Saren125/dc-dc/eskd documentation/dc-dc преобразователь перечень элементов.pdf

Изм. Лист | № докум. | Подп. | Дата
| Разраб. | | | Преoбразователь DC-DC понижающий импульсный Перечень элементов | Лит. | Лист | Листов
Пров. | | | | | | 1 2
Н.контр. Инв. № подл. Подп. и дата Взам. инв. № Инв. № дубл. Подп. и дата | Утв. Справ. № Перв. примен. | Конденсаторы
C1,C3 | Конденсатор керамический 0.1 мкФ 50В 10% 0603 GCM188R71H104KA57D Murata | 2
C2 | Конденсатор керамический 10 мкФ 50В 10% 1210 10мкФ X7R 50В 10% 1210, GRM32ER71H106K Murata | 1
C4,C5 | Конденсатор керамический 22 мкФ 16В 10% 0603 GRM188R61C225KE15D Murata | 2
C6 | Конденсатор керамический 10 нФ 50В 5% 0603 GRM1885C1H103JA01D Murata | 1

Фильтры

FL1 | Фильтр DLW5BTM102SQ2L Murata | 1
| Предохранители
FU1 | Предохранитель самовосстанавливающийся 30В 2.6A 1812 1812L260/30MR LittleFuse | 1
| Катушки индуктивности
L1 | Катушка индуктивности 15 мкГн CDSPRH127-150M SCE | 1
| Резисторы
R1 | Резистор 10 кОм 0.1 Вт 0603 RT0603BRB0710KL Yageo | 1
R2,R3 Резистор 100 кОм 0.1 Вт 0603 RT0603BRD07100KL Yageo | | 2
R4 | Резистор 91 кОм 0.1 Вт 0603 RC0603FR-0791KL Yageo | 1
R5 | Резистор 17.8 кОм 0.1 Вт 0603 RC0603FR-0717K8L Yageo | 1

Поз.
обозначение
Наименование | Кол. Примечание
Копировал | Формат A4

Лист

2 Инв. № подл. Подп. и дата Взам. инв. № Инв. № дубл. Подп. и дата | Изм. Лист | № докум. | Подп. | Дата

Микросхемы

U1 | DC-DC преобразователь понижающий ADJ 3.5А 200кГц-2.5МГц LMR14030SDDAR Texas Instruments | 1
| Приборы полупроводниковые
VD1 | Диод защитный 24В 1500Вт SMC SMCJ24A EVER SEMICONDUCTOR | 1
VD2 | Стабилитрон 12В 0.2Вт SOD-323 BZT52C12S Hottech | 1
VD3 | Диод Шоттки SMB SK56B Hottech | 1
VT1 | Транзистор P-MOSFET 30В 4.1А AO3407A SOT-23-3 Youtai | 1

Соединители

X1,X2 Клеммник винтовой, 2-контактный, 5мм, прямой на плату DG300-5.0-02P-12 2

Поз.
обозначение
Наименование | Кол. Примечание
Копировал | Формат A4
