Saren125/dc-dc/3d.jpg

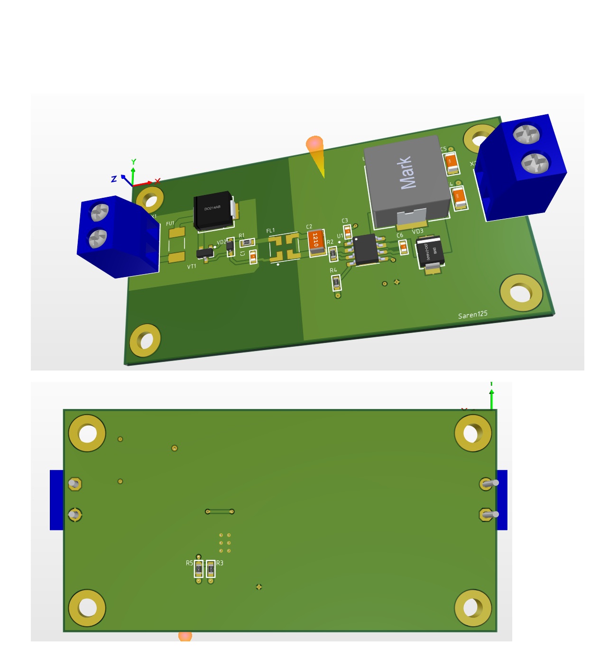
3d.jpg
