Saren125/dc-dc/eskd documentation/converter schematic.pdf

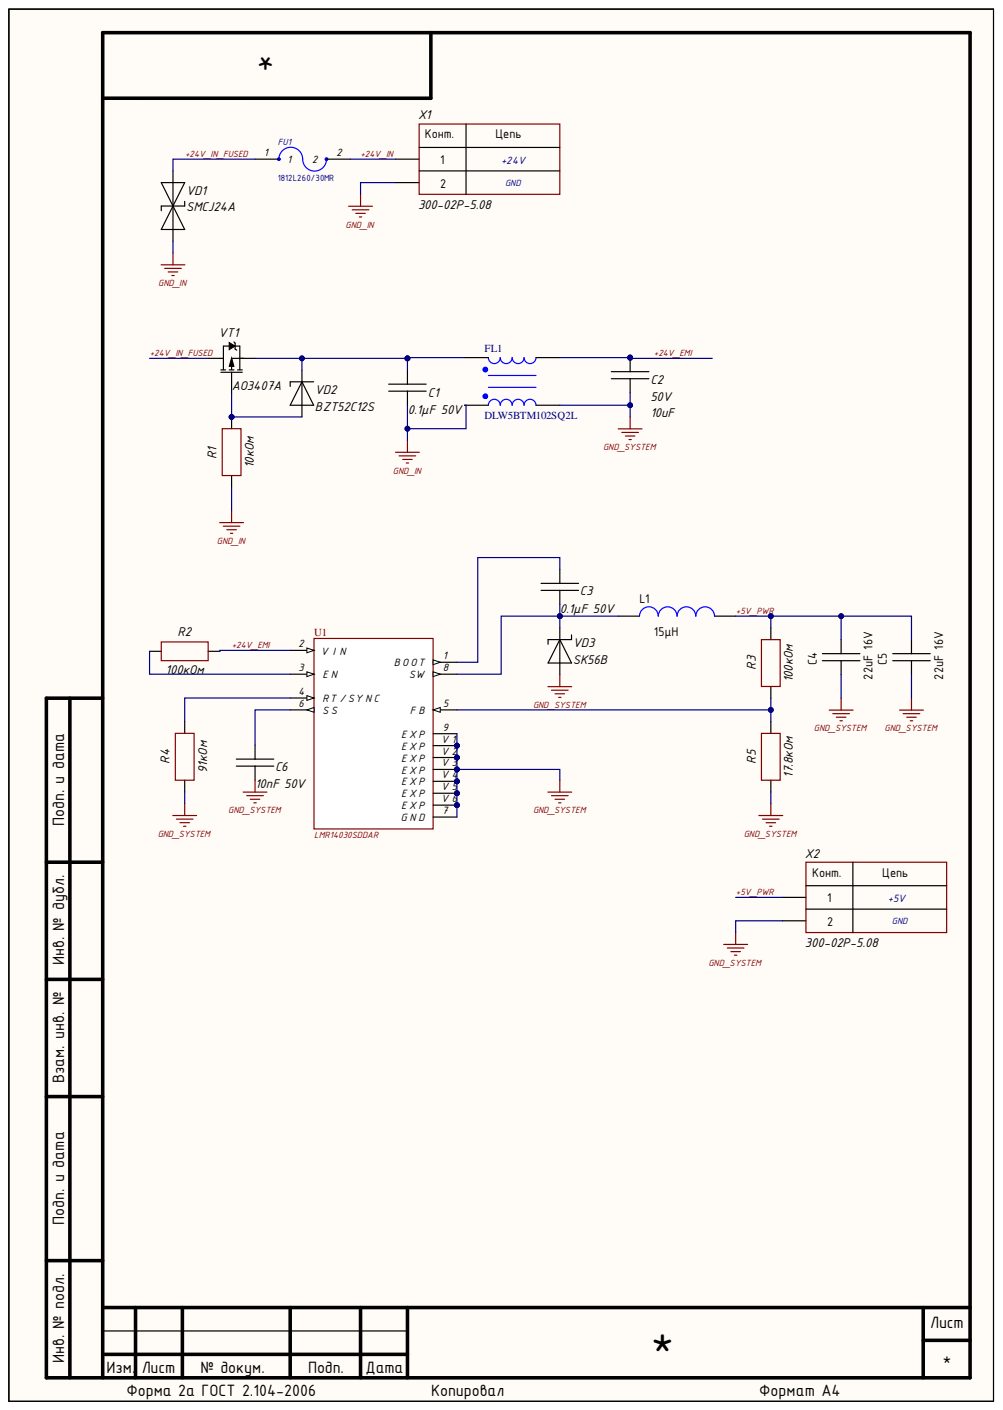
[picture p2: page 1]

Конт. | Цепь

SS 6 | GND_SYSTEM

Инв. № подл. Подп. и дата Взам. инв. № Инв. № дубл. Подп. и дата

2 | GND
