Saren125/dc-dc/(list of files, drawings)

Other design files:
altium project/buck coverter LMR14030SDDAR.PrjPcb
altium project/converter pcb.PcbDoc
altium project/converter schematic.SchDoc
